alexcwu1121/hammerhead-sensor-module/kicad/hammerhead_sensor_module.step

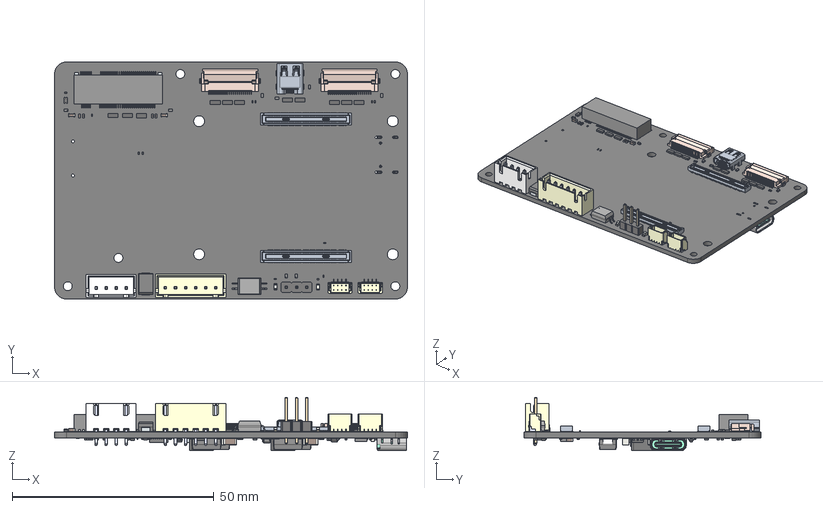
[picture p1: CAD file, 2026-08-22]
kicad/hammerhead_sensor_module.step
87.5 x 58.8 x 13.3 mm
10164227-1001a1rlf x 2
BaseWithTopCut x 25
TopCircle_NewBody x 25
DQA0010B_BODY x 15
DQA0010B_FRAME x 15
DQA0010B_PIN1-ID x 15
C_0402_1005Metric x 6
R_0201_0603Metric x 31
FH12-22S-0.5SH_Èª x 2
D_0603_1608Metric
LED_0603_1608Metric x 2
B6B-XH-A_LF__SN_
BxB-XH-A_04
FilletPin1
FilletPin2
C_0603_1608Metric x 3
Pins
Lugs
C_0201_0603Metric x 16
PinHeader_1x03_P2.54mm_Vertical
BM04B-SRSS-TB x 2
218-2-GULLWING_CTS
25TQC100MD3 x 2
C_1206_3216Metric x 6
R_0402_1005Metric x 2
BODY-SOT
LEAD-SOT x 5
LEAD-DUMMY
ETQP3M4R7KVN x 2
12402012E212A
PinsArrayLR x 3
SOT-416_1P65X0P9_ONS
ThermalPin
PinsArrayTB
TXB0108RGYR
10TPE220ML x 2
TSOT-23
term1
term2
hammerhead_sensor_module_PCB
