alexcwu1121/hammerhead-sensor-module/kicad/hammerhead_sensor_module.kicad_pcb

## KiCad design kicad/hammerhead_sensor_module.kicad_pcb (2026-08-26)

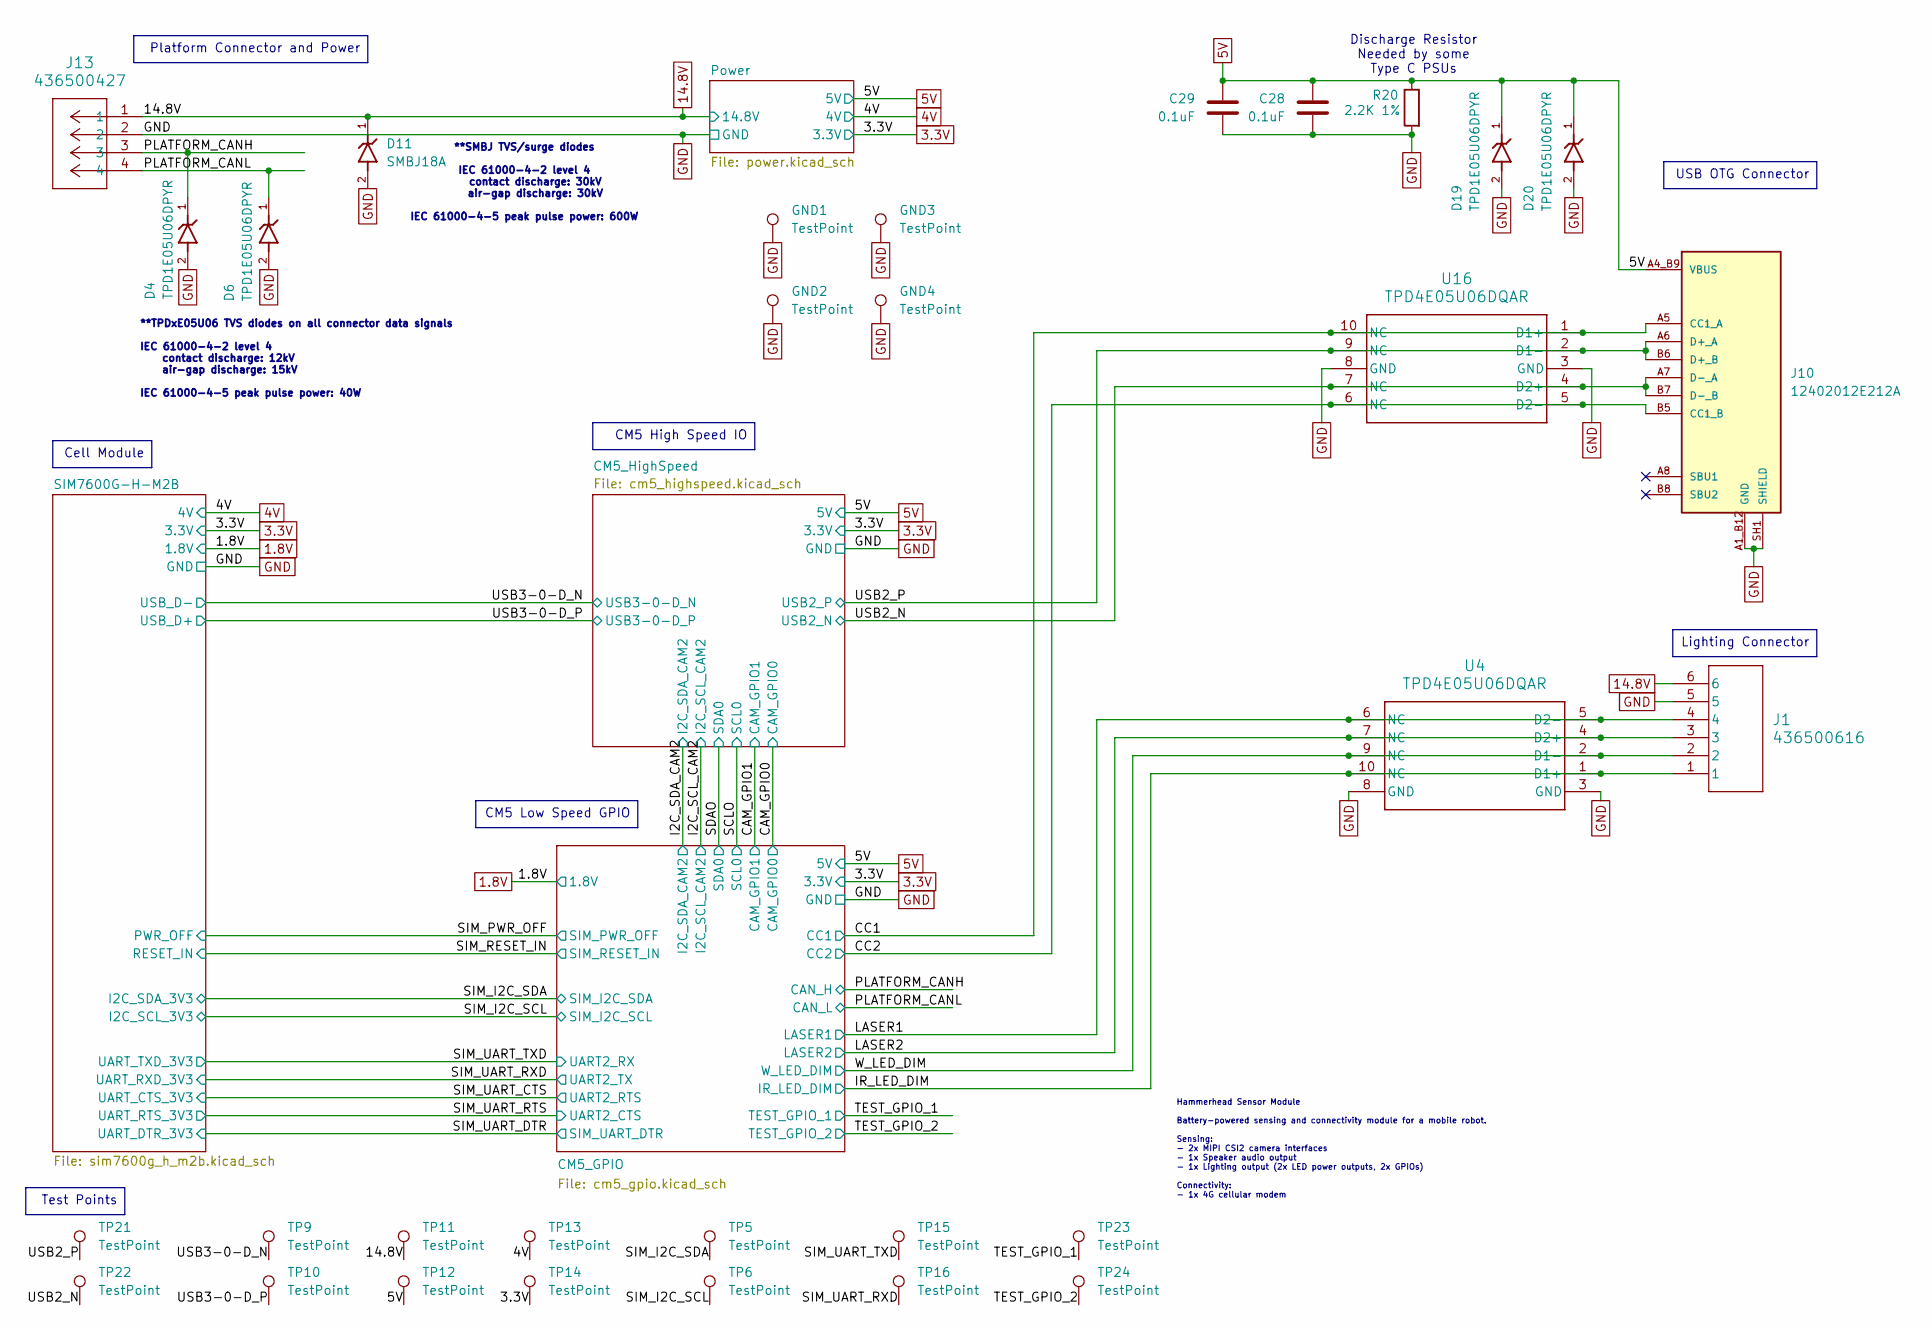
[picture p2: schematic hammerhead_sensor_module.kicad_sch]

Parts:
C28, C29: 0.1uF; C_0201_0603Metric
D4, D6, D19, D20: TPD1E05U06DPYR; SON65P60X100X45-2N
D11: SMBJ18A; DIOM5436X261N; PARTREV JC.07/04/25 v4
GND1, GND2, GND3, GND4: TestPoint; TestPoint_Pad_1.0x1.0mm
J1: 436500616; CONN_SD-43650-006_06_MOL
J10: 12402012E212A; AMPHENOL_12402012E212A; PARTREV 4
J13: 436500427; CONN_SD-43650-010_04_MOL
R20: 2.2K 1%; R_0201_0603Metric; Part Description Resistor 2.2K M1005 1% 63mW
TP5, TP6, TP9, TP10, TP11, TP12, TP13, TP14, TP15, TP16, TP21, TP22, TP23, TP24: TestPoint; TestPoint_Pad_1.0x1.0mm
U4, U16: TPD4E05U06DQAR; DQA0010A

Connections:
3.3V: TP14.1; also elsewhere on the board
4V: TP13.1; also elsewhere on the board
5V: C28.1, C29.1, D19.1, D20.1, J10.A4_B9 (VBUS), J10.B4_A9 (VBUS), R20.1, TP12.1; also elsewhere on the board
14.8V: D11.1, J1.6, J13.1, TP11.1; also elsewhere on the board
/CC1: J10.A5 (CC1_A), U16.1 (D1+), U16.10 (NC); also elsewhere on the board
/CC2: J10.B5 (CC1_B), U16.5 (D2-), U16.6 (NC); also elsewhere on the board
/IR_LED_DIM: J1.1, U4.1 (D1+), U4.10 (NC); also elsewhere on the board
/LASER1: J1.4, U4.5 (D2-), U4.6 (NC); also elsewhere on the board
/LASER2: J1.3, U4.4 (D2+), U4.7 (NC); also elsewhere on the board
/PLATFORM_CANH: D4.1, J13.3; also elsewhere on the board
/PLATFORM_CANL: D6.1, J13.4; also elsewhere on the board
/SIM_I2C_SCL: TP6.1; also elsewhere on the board
/SIM_I2C_SDA: TP5.1; also elsewhere on the board
/SIM_UART_RXD: TP16.1; also elsewhere on the board
/SIM_UART_TXD: TP15.1; also elsewhere on the board
/TEST_GPIO_1: TP23.1; also elsewhere on the board
/TEST_GPIO_2: TP24.1; also elsewhere on the board
/USB2_N: J10.A7 (D-_A), J10.B7 (D-_B), TP22.1, U16.4 (D2+), U16.7 (NC); also elsewhere on the board
/USB2_P: J10.A6 (D+_A), J10.B6 (D+_B), TP21.1, U16.2 (D1-), U16.9 (NC); also elsewhere on the board
/USB3-0-D_N: TP9.1; also elsewhere on the board
/USB3-0-D_P: TP10.1; also elsewhere on the board
/W_LED_DIM: J1.2, U4.2 (D1-), U4.9 (NC); also elsewhere on the board
GND: C28.2, C29.2, D4.2, D6.2, D11.2, D19.2, D20.2, GND1.1, GND2.1, GND3.1, GND4.1, J1.5, J10.A1_B12 (GND), J10.B1_A12 (GND), J10.SH1 (SHIELD), J10.SH2 (SHIELD), J10.SH3 (SHIELD), J10.SH4 (SHIELD), J13.2, R20.2, U4.3 (GND), U4.8 (GND), U16.3 (GND), U16.8 (GND); also elsewhere on the board

Notes on the sheet:
Hammerhead Sensor Module Battery-powered sensing and connectivity module for a mobile robot. Sensing: - 2x MIPI CSI2 camera interfaces - 1x Speaker audio output - 1x Lighting output (2x LED power outputs, 2x GPIOs) Connectivity: - 1x 4G cellular modem
**SMBJ TVS/surge diodes IEC 61000-4-2 level 4 contact discharge: 30kV air-gap discharge: 30kV IEC 61000-4-5 peak pulse power: 600W
**TPDxE05U06 TVS diodes on all connector data signals IEC 61000-4-2 level 4 contact discharge: 12kV air-gap discharge: 15kV IEC 61000-4-5 peak pulse power: 40W
Discharge Resistor Needed by some Type C PSUs
Cell Module
Test Points
USB OTG Connector
CM5 High Speed IO
Platform Connector and Power
Lighting Connector
CM5 Low Speed GPIO

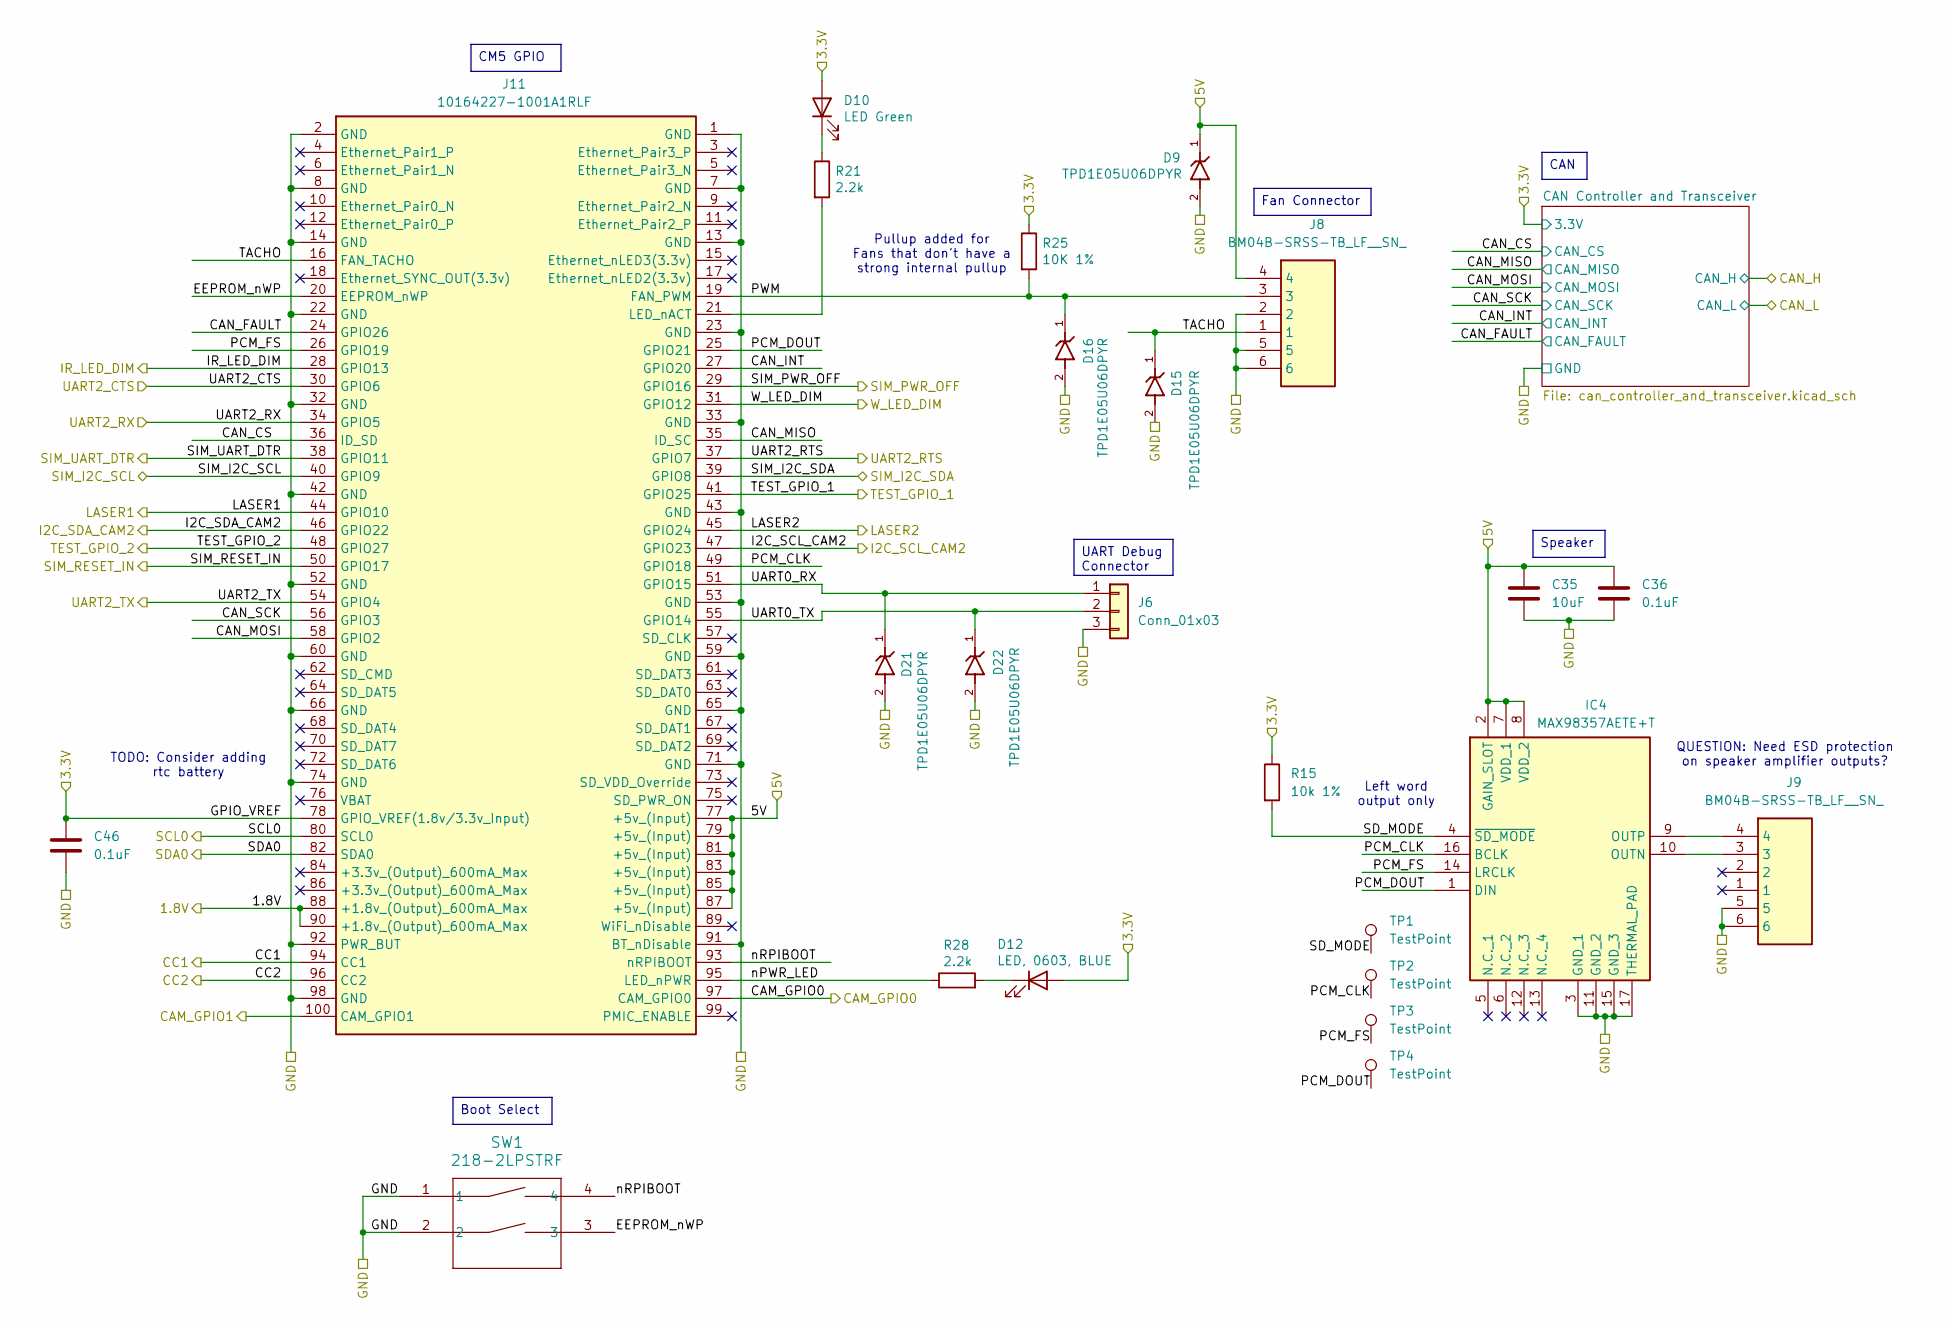
[picture p3: schematic cm5_gpio.kicad_sch]

Parts:
C35: 10uF; C_0603_1608Metric
C36, C46: 0.1uF; C_0201_0603Metric
D9, D15, D16, D21, D22: TPD1E05U06DPYR; SON65P60X100X45-2N
D10: LED Green; LED_0603_1608Metric; Part Description Green 572nm LED Indication - Discrete 2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
D12: LED, 0603, BLUE; LED_0603_1608Metric; Part Description Red 620nm LED Indication - Discrete 2.2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
IC4: MAX98357AETE+T; QFN50P300X300X80-17N; Manufacturer_Part_Number MAX98357AETE+T; Mouser Part Number 700-MAX98357AETE+T
J6: Conn_01x03; PinHeader_1x03_P2.54mm_Vertical
J8, J9: BM04B-SRSS-TB_LF__SN_; BM04B-SRSS-TB_LFSN_; Manufacturer_Part_Number BM04B-SRSS-TB(LF)(SN); Mouser Part Number N/A
J11: 10164227-1001A1RLF; 101642271001A1RLF; Manufacturer_Part_Number 10164227-1001A1RLF; Mouser Part Number 649-01642271001A1RLF
R15: 10k 1%; R_0201_0603Metric
R21, R28: 2.2k; R_0201_0603Metric; Part Description Resistor 1K M1005 1% 63mW
R25: 10K 1%; R_0201_0603Metric; Part Description Resistor 10K M1005 1% 63mW
SW1: 218-2LPSTRF; 218-2-GULLWING_CTS
TP1, TP2, TP3, TP4: TestPoint; TestPoint_Pad_1.0x1.0mm

Connections:
1.8V: J11.88 (+1.8v_(Output)_600mA_Max), J11.90 (+1.8v_(Output)_600mA_Max); also elsewhere on the board
3.3V: C46.1, D10.2 (A), D12.2 (A), J11.78 (GPIO_VREF(1.8v/3.3v_Input)), R15.1, R25.1; also elsewhere on the board
5V: C35.1, C36.1, D9.1, IC4.2 (GAIN_SLOT), IC4.7 (VDD_1), IC4.8 (VDD_2), J8.4, J11.77 (+5v_(Input)), J11.79 (+5v_(Input)), J11.81 (+5v_(Input)), J11.83 (+5v_(Input)), J11.85 (+5v_(Input)), J11.87 (+5v_(Input)); also elsewhere on the board
/CAM_GPIO0: J11.97 (CAM_GPIO0); also elsewhere on the board
/CAM_GPIO1: J11.100 (CAM_GPIO1); also elsewhere on the board
/CC1: J11.94 (CC1); also elsewhere on the board
/CC2: J11.96 (CC2); also elsewhere on the board
/CM5_GPIO/CAN_CS: J11.36 (ID_SD); also elsewhere on the board
/CM5_GPIO/CAN_FAULT: J11.24 (GPIO26); also elsewhere on the board
/CM5_GPIO/CAN_INT: J11.27 (GPIO20); also elsewhere on the board
/CM5_GPIO/CAN_MISO: J11.35 (ID_SC); also elsewhere on the board
/CM5_GPIO/CAN_MOSI: J11.58 (GPIO2); also elsewhere on the board
/CM5_GPIO/CAN_SCK: J11.56 (GPIO3); also elsewhere on the board
/CM5_GPIO/EEPROM_nWP: J11.20 (EEPROM_nWP), SW1.3
/CM5_GPIO/PCM_CLK: IC4.16 (BCLK), J11.49 (GPIO18), TP2.1
/CM5_GPIO/PCM_DOUT: IC4.1 (DIN), J11.25 (GPIO21), TP4.1
/CM5_GPIO/PCM_FS: IC4.14 (LRCLK), J11.26 (GPIO19), TP3.1
/CM5_GPIO/PWM: D16.1, J8.3, J11.19 (FAN_PWM), R25.2
/CM5_GPIO/SD_MODE: IC4.4 (~SD_MODE), R15.2, TP1.1
/CM5_GPIO/TACHO: D15.1, J8.1, J11.16 (FAN_TACHO)
/CM5_GPIO/UART0_RX: D21.1, J6.1, J11.51 (GPIO15)
/CM5_GPIO/UART0_TX: D22.1, J6.2, J11.55 (GPIO14)
/CM5_GPIO/nPWR_LED: J11.95 (LED_nPWR), R28.1
/CM5_GPIO/nRPIBOOT: J11.93 (nRPIBOOT), SW1.4
/I2C_SCL_CAM2: J11.47 (GPIO23); also elsewhere on the board
/I2C_SDA_CAM2: J11.46 (GPIO22); also elsewhere on the board
/IR_LED_DIM: J11.28 (GPIO13); also elsewhere on the board
/LASER1: J11.44 (GPIO10); also elsewhere on the board
/LASER2: J11.45 (GPIO24); also elsewhere on the board
/SCLO: J11.80 (SCL0); also elsewhere on the board
/SDAO: J11.82 (SDA0); also elsewhere on the board
/SIM_I2C_SCL: J11.40 (GPIO9); also elsewhere on the board
/SIM_I2C_SDA: J11.39 (GPIO8); also elsewhere on the board
/SIM_PWR_OFF: J11.29 (GPIO16); also elsewhere on the board
/SIM_RESET_IN: J11.50 (GPIO17); also elsewhere on the board
/SIM_UART_CTS: J11.37 (GPIO7); also elsewhere on the board
/SIM_UART_DTR: J11.38 (GPIO11); also elsewhere on the board
/SIM_UART_RTS: J11.30 (GPIO6); also elsewhere on the board
/SIM_UART_RXD: J11.54 (GPIO4); also elsewhere on the board
/SIM_UART_TXD: J11.34 (GPIO5); also elsewhere on the board
/TEST_GPIO_1: J11.41 (GPIO25); also elsewhere on the board
/TEST_GPIO_2: J11.48 (GPIO27); also elsewhere on the board
/W_LED_DIM: J11.31 (GPIO12); also elsewhere on the board
GND: C35.2, C36.2, C46.2, D9.2, D15.2, D16.2, D21.2, D22.2, IC4.3 (GND_1), IC4.11 (GND_2), IC4.15 (GND_3), IC4.17 (THERMAL_PAD), J6.3, J8.2, J8.5, J8.6, J9.5, J9.6, J11.1 (GND), J11.2 (GND), J11.7 (GND), J11.8 (GND), J11.13 (GND), J11.14 (GND), J11.22 (GND), J11.23 (GND), J11.32 (GND), J11.33 (GND), J11.42 (GND), J11.43 (GND), J11.52 (GND), J11.53 (GND), J11.59 (GND), J11.60 (GND), J11.65 (GND), J11.66 (GND), J11.71 (GND), J11.74 (GND), J11.91 (BT_nDisable), J11.92 (PWR_BUT), J11.98 (GND), SW1.1, SW1.2; also elsewhere on the board
unnamed: D10.1 (K), R21.1
unnamed: D12.1 (K), R28.2
unnamed: IC4.10 (OUTN), J9.3
unnamed: IC4.9 (OUTP), J9.4
unnamed: J11.21 (LED_nACT), R21.2

Notes on the sheet:
TODO: Consider adding rtc battery
Pullup added for Fans that don't have a strong internal pullup
QUESTION: Need ESD protection on speaker amplifier outputs?
Left word output only
UART Debug Connector
CM5 GPIO
Speaker
Boot Select
Fan Connector
CAN

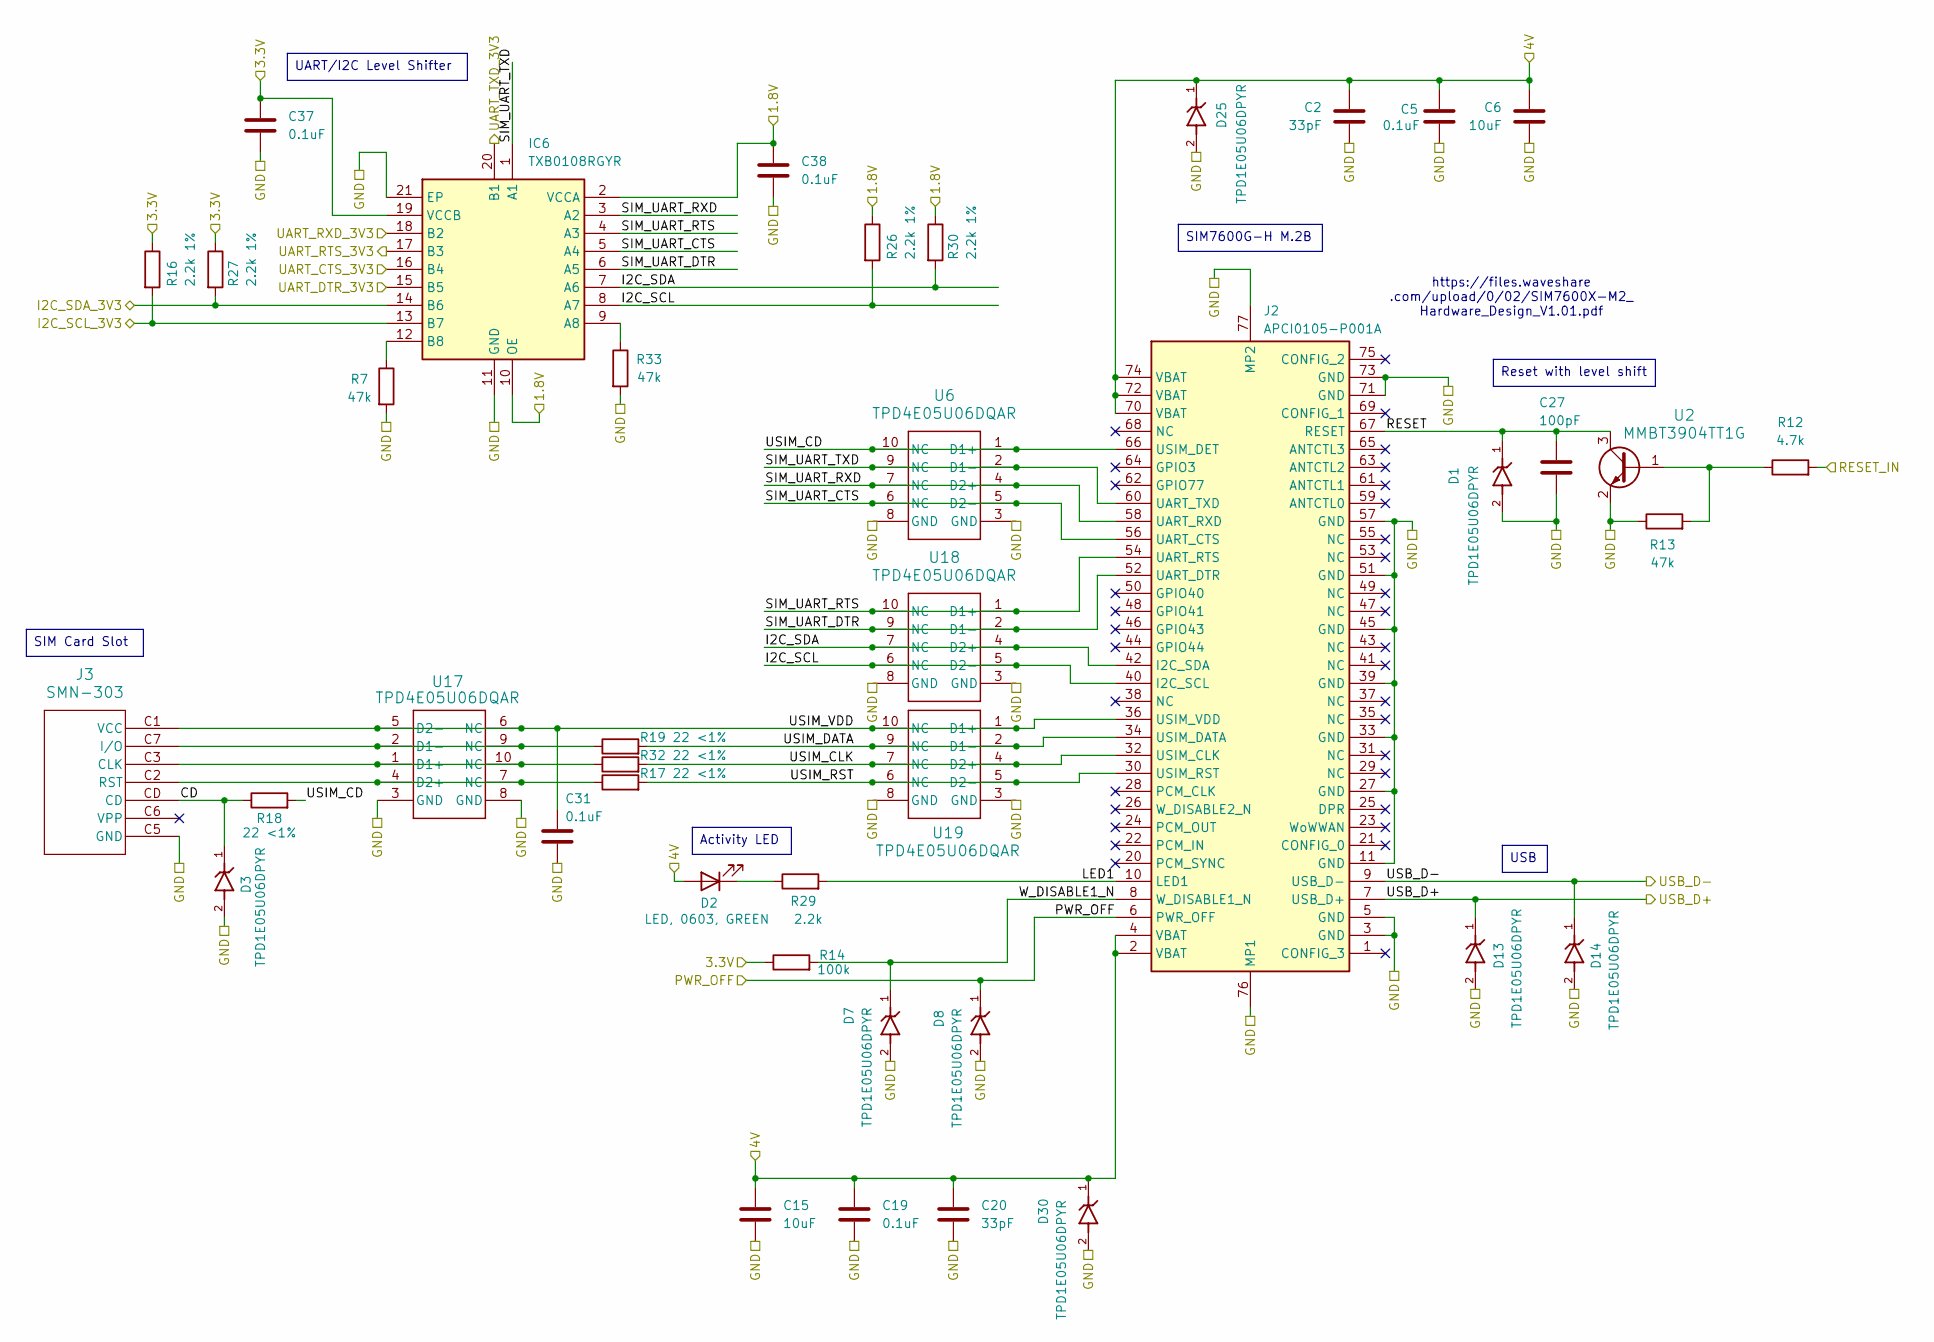
[picture p4: schematic sim7600g_h_m2b.kicad_sch]

Parts:
C2, C20: 33pF; C_0402_1005Metric
C5, C19: 0.1uF; C_0402_1005Metric
C6, C15: 10uF; C_0603_1608Metric
C27: 100pF; C_0201_0603Metric
C31, C37, C38: 0.1uF; C_0201_0603Metric
D1, D3, D7, D8, D13, D14, D25, D30: TPD1E05U06DPYR; SON65P60X100X45-2N
D2: LED, 0603, GREEN; D_0603_1608Metric
IC6: TXB0108RGYR; SN74LVC541ARGYR; Manufacturer_Part_Number TXB0108RGYR; Mouser Part Number 595-TXB0108RGYR
J2: APCI0105-P001A; APCI0105P001A; Manufacturer_Part_Number APCI0105-P001A
J3: SMN-303; SMN-303_XNP
R7, R13, R33: 47k; R_0201_0603Metric
R12: 4.7k; R_0201_0603Metric
R14: 100k; R_0201_0603Metric
R16, R26, R27, R30: 2.2k 1%; R_0201_0603Metric
R17, R18, R19, R32: 22 <1%; R_0201_0603Metric
R29: 2.2k; R_0201_0603Metric
U2: MMBT3904TT1G; SOT-416_1P65X0P9_ONS-L
U6, U17, U18, U19: TPD4E05U06DQAR; DQA0010A

Connections:
1.8V: C38.1, IC6.2 (VCCA), IC6.10 (OE), R26.1, R30.1; also elsewhere on the board
3.3V: C37.1, IC6.19 (VCCB), R14.1, R16.1, R27.1; also elsewhere on the board
4V: C2.1, C5.1, C6.1, C15.1, C19.1, C20.1, D2.2 (A), D25.1, D30.1, J2.2 (VBAT), J2.4 (VBAT), J2.70 (VBAT), J2.72 (VBAT), J2.74 (VBAT); also elsewhere on the board
/SIM7600G-H-M2B/CD: D3.1, J3.CD, R18.1
/SIM7600G-H-M2B/I2C_SCL: IC6.8 (A7), J2.40 (I2C_SCL), R26.2, U18.5 (D2-), U18.6 (NC)
/SIM7600G-H-M2B/I2C_SDA: IC6.7 (A6), J2.42 (I2C_SDA), R30.2, U18.4 (D2+), U18.7 (NC)
/SIM7600G-H-M2B/LED1: J2.10 (LED1), R29.2
/SIM7600G-H-M2B/RESET: C27.1, D1.1, J2.67 (RESET), U2.3
/SIM7600G-H-M2B/SIM_UART_CTS: IC6.5 (A4), J2.56 (UART_CTS), U6.5 (D2-), U6.6 (NC)
/SIM7600G-H-M2B/SIM_UART_DTR: IC6.6 (A5), J2.52 (UART_DTR), U18.2 (D1-), U18.9 (NC)
/SIM7600G-H-M2B/SIM_UART_RTS: IC6.4 (A3), J2.54 (UART_RTS), U18.1 (D1+), U18.10 (NC)
/SIM7600G-H-M2B/SIM_UART_RXD: IC6.3 (A2), J2.58 (UART_RXD), U6.4 (D2+), U6.7 (NC)
/SIM7600G-H-M2B/SIM_UART_TXD: IC6.1 (A1), J2.60 (UART_TXD), U6.2 (D1-), U6.9 (NC)
/SIM7600G-H-M2B/USIM_CD: J2.66 (USIM_DET), R18.2, U6.1 (D1+), U6.10 (NC)
/SIM7600G-H-M2B/USIM_CLK: J2.32 (USIM_CLK), R32.2, U19.4 (D2+), U19.7 (NC)
/SIM7600G-H-M2B/USIM_DATA: J2.34 (USIM_DATA), R19.2, U19.2 (D1-), U19.9 (NC)
/SIM7600G-H-M2B/USIM_RST: J2.30 (USIM_RST), R17.2, U19.5 (D2-), U19.6 (NC)
/SIM7600G-H-M2B/USIM_VDD: C31.1, J2.36 (USIM_VDD), J3.C1 (VCC), U17.5 (D2-), U17.6 (NC), U19.1 (D1+), U19.10 (NC)
/SIM7600G-H-M2B/W_DISABLE1_N: D7.1, J2.8 (W_DISABLE1_N), R14.2
/SIM_I2C_SCL: IC6.13 (B7), R16.2; also elsewhere on the board
/SIM_I2C_SDA: IC6.14 (B6), R27.2; also elsewhere on the board
/SIM_PWR_OFF: D8.1, J2.6 (PWR_OFF); also elsewhere on the board
/SIM_RESET_IN: R12.2; also elsewhere on the board
/SIM_UART_CTS: IC6.16 (B4); also elsewhere on the board
/SIM_UART_DTR: IC6.15 (B5); also elsewhere on the board
/SIM_UART_RTS: IC6.17 (B3); also elsewhere on the board
/SIM_UART_RXD: IC6.18 (B2); also elsewhere on the board
/SIM_UART_TXD: IC6.20 (B1); also elsewhere on the board
/USB3-0-D_N: D14.1, J2.9 (USB_D-); also elsewhere on the board
/USB3-0-D_P: D13.1, J2.7 (USB_D+); also elsewhere on the board
GND: C2.2, C5.2, C6.2, C15.2, C19.2, C20.2, C27.2, C31.2, C37.2, C38.2, D1.2, D3.2, D7.2, D8.2, D13.2, D14.2, D25.2, D30.2, IC6.11 (GND), IC6.21 (EP), J2.3 (GND), J2.5 (GND), J2.11 (GND), J2.27 (GND), J2.33 (GND), J2.39 (GND), J2.45 (GND), J2.51 (GND), J2.57 (GND), J2.71 (GND), J2.73 (GND), J2.76 (MP1), J2.77 (MP2), J3.C5 (GND), R7.2, R13.1, R33.2, U2.2, U6.3 (GND), U6.8 (GND), U17.3 (GND), U17.8 (GND), U18.3 (GND), U18.8 (GND), U19.3 (GND), U19.8 (GND); also elsewhere on the board
unnamed: D2.1 (K), R29.1
unnamed: IC6.9 (A8), R33.1
unnamed: IC6.12 (B8), R7.1
unnamed: J3.C3 (CLK), R32.1, U17.1 (D1+), U17.10 (NC)
unnamed: J3.C7 (I/O), R19.1, U17.2 (D1-), U17.9 (NC)
unnamed: J3.C2 (RST), R17.1, U17.4 (D2+), U17.7 (NC)
unnamed: R12.1, R13.2, U2.1

Notes on the sheet:
https://files.waveshare .com/upload/0/02/SIM7600X-M2_ Hardware_Design_V1.01.pdf
USB
Reset with level shift
SIM Card Slot
SIM7600G-H M.2B
Activity LED
UART/I2C Level Shifter

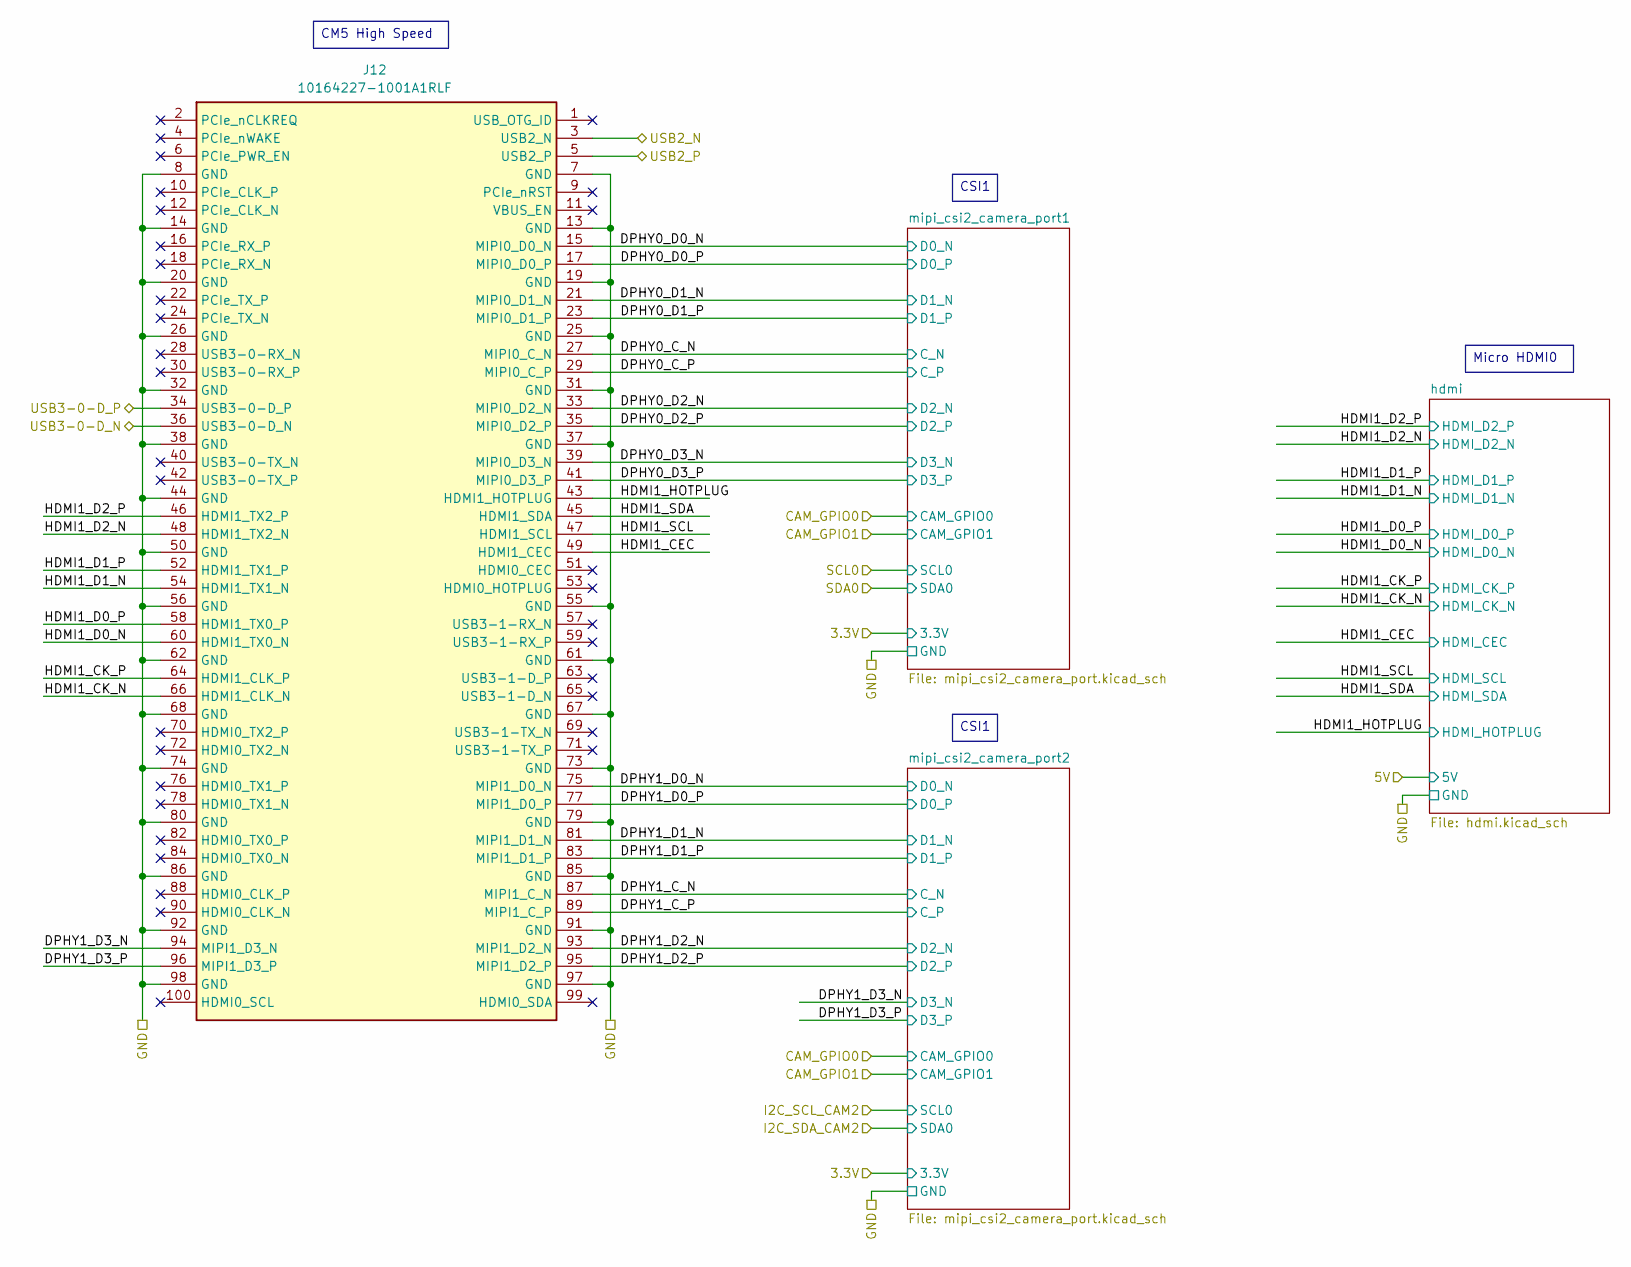
[picture p5: schematic cm5_highspeed.kicad_sch]

Parts:
J12: 10164227-1001A1RLF; 101642271001A1RLF; Manufacturer_Part_Number 10164227-1001A1RLF; Mouser Part Number 649-01642271001A1RLF

Connections:
/CM5_HighSpeed/DPHY0_C_N: J12.27 (MIPI0_C_N); also elsewhere on the board
/CM5_HighSpeed/DPHY0_C_P: J12.29 (MIPI0_C_P); also elsewhere on the board
/CM5_HighSpeed/DPHY0_D0_N: J12.15 (MIPI0_D0_N); also elsewhere on the board
/CM5_HighSpeed/DPHY0_D0_P: J12.17 (MIPI0_D0_P); also elsewhere on the board
/CM5_HighSpeed/DPHY0_D1_N: J12.21 (MIPI0_D1_N); also elsewhere on the board
/CM5_HighSpeed/DPHY0_D1_P: J12.23 (MIPI0_D1_P); also elsewhere on the board
/CM5_HighSpeed/DPHY0_D2_N: J12.33 (MIPI0_D2_N); also elsewhere on the board
/CM5_HighSpeed/DPHY0_D2_P: J12.35 (MIPI0_D2_P); also elsewhere on the board
/CM5_HighSpeed/DPHY0_D3_N: J12.39 (MIPI0_D3_N); also elsewhere on the board
/CM5_HighSpeed/DPHY0_D3_P: J12.41 (MIPI0_D3_P); also elsewhere on the board
/CM5_HighSpeed/DPHY1_C_N: J12.87 (MIPI1_C_N); also elsewhere on the board
/CM5_HighSpeed/DPHY1_C_P: J12.89 (MIPI1_C_P); also elsewhere on the board
/CM5_HighSpeed/DPHY1_D0_N: J12.75 (MIPI1_D0_N); also elsewhere on the board
/CM5_HighSpeed/DPHY1_D0_P: J12.77 (MIPI1_D0_P); also elsewhere on the board
/CM5_HighSpeed/DPHY1_D1_N: J12.81 (MIPI1_D1_N); also elsewhere on the board
/CM5_HighSpeed/DPHY1_D1_P: J12.83 (MIPI1_D1_P); also elsewhere on the board
/CM5_HighSpeed/DPHY1_D2_N: J12.93 (MIPI1_D2_N); also elsewhere on the board
/CM5_HighSpeed/DPHY1_D2_P: J12.95 (MIPI1_D2_P); also elsewhere on the board
/CM5_HighSpeed/DPHY1_D3_N: J12.94 (MIPI1_D3_N); also elsewhere on the board
/CM5_HighSpeed/DPHY1_D3_P: J12.96 (MIPI1_D3_P); also elsewhere on the board
/CM5_HighSpeed/HDMI1_CEC: J12.49 (HDMI1_CEC); also elsewhere on the board
/CM5_HighSpeed/HDMI1_CK_N: J12.66 (HDMI1_CLK_N); also elsewhere on the board
/CM5_HighSpeed/HDMI1_CK_P: J12.64 (HDMI1_CLK_P); also elsewhere on the board
/CM5_HighSpeed/HDMI1_D0_N: J12.60 (HDMI1_TX0_N); also elsewhere on the board
/CM5_HighSpeed/HDMI1_D0_P: J12.58 (HDMI1_TX0_P); also elsewhere on the board
/CM5_HighSpeed/HDMI1_D1_N: J12.54 (HDMI1_TX1_N); also elsewhere on the board
/CM5_HighSpeed/HDMI1_D1_P: J12.52 (HDMI1_TX1_P); also elsewhere on the board
/CM5_HighSpeed/HDMI1_D2_N: J12.48 (HDMI1_TX2_N); also elsewhere on the board
/CM5_HighSpeed/HDMI1_D2_P: J12.46 (HDMI1_TX2_P); also elsewhere on the board
/CM5_HighSpeed/HDMI1_HOTPLUG: J12.43 (HDMI1_HOTPLUG); also elsewhere on the board
/CM5_HighSpeed/HDMI1_SCL: J12.47 (HDMI1_SCL); also elsewhere on the board
/CM5_HighSpeed/HDMI1_SDA: J12.45 (HDMI1_SDA); also elsewhere on the board
/USB2_N: J12.3 (USB2_N); also elsewhere on the board
/USB2_P: J12.5 (USB2_P); also elsewhere on the board
/USB3-0-D_N: J12.36 (USB3-0-D_N); also elsewhere on the board
/USB3-0-D_P: J12.34 (USB3-0-D_P); also elsewhere on the board
GND: J12.7 (GND), J12.8 (GND), J12.13 (GND), J12.14 (GND), J12.19 (GND), J12.20 (GND), J12.25 (GND), J12.26 (GND), J12.31 (GND), J12.32 (GND), J12.37 (GND), J12.38 (GND), J12.44 (GND), J12.50 (GND), J12.55 (GND), J12.56 (GND), J12.61 (GND), J12.62 (GND), J12.67 (GND), J12.68 (GND), J12.73 (GND), J12.74 (GND), J12.79 (GND), J12.80 (GND), J12.85 (GND), J12.86 (GND), J12.91 (GND), J12.92 (GND), J12.97 (GND), J12.98 (GND); also elsewhere on the board

Notes on the sheet:
CSI1
Micro HDMI0
CM5 High Speed

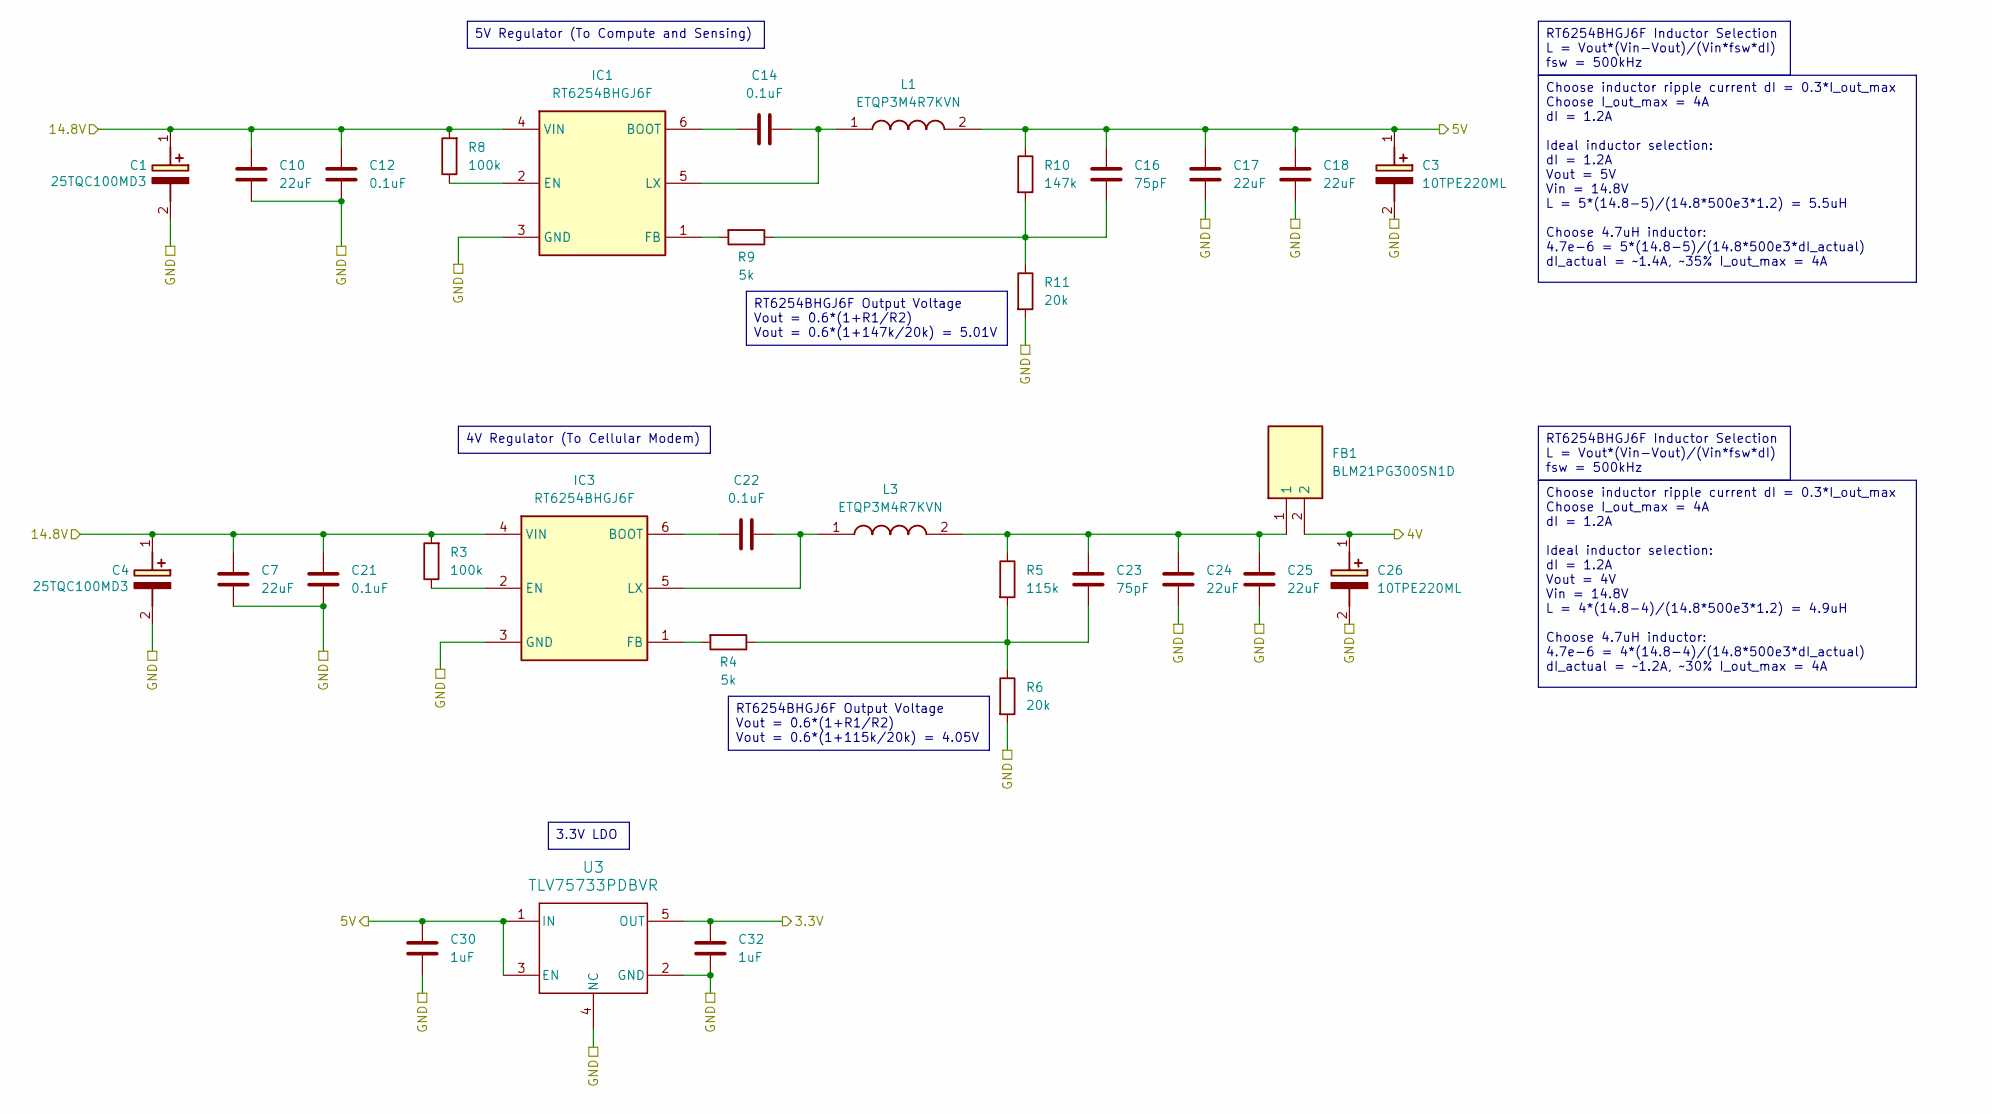
[picture p6: schematic power.kicad_sch]

Parts:
C1, C4: 25TQC100MD3; 16TDC150MYF; Manufacturer_Part_Number 25TQC100MD3; Mouser Part Number 667-25TQC100MD3
C3, C26: 10TPE220ML; 16TDC150MYF; Manufacturer_Part_Number 10TPE220ML; Mouser Part Number 667-10TPE220ML
C7, C10, C17, C18, C24, C25: 22uF; C_1206_3216Metric
C12, C14, C21, C22: 0.1uF; C_0201_0603Metric
C16, C23: 75pF; C_0201_0603Metric
C30, C32: 1uF; C_0201_0603Metric
FB1: BLM21PG300SN1D; BEADC2012X105N; Manufacturer_Part_Number BLM21PG300SN1D; Mouser Part Number 81-BLM21P300S
IC1, IC3: RT6254BHGJ6F; SOT95P280X100-6N; Manufacturer_Part_Number RT6254BHGJ6F; Mouser Part Number 835-RT6254BHGJ6F
L1, L3: ETQP3M4R7KVN; ETQP3M1R0KVN; Manufacturer_Part_Number ETQP3M4R7KVN
R3, R8: 100k; R_0201_0603Metric
R4, R9: 5k; R_0201_0603Metric
R5: 115k; R_0402_1005Metric
R6, R11: 20k; R_0201_0603Metric
R10: 147k; R_0402_1005Metric
U3: TLV75733PDBVR; DBV0005A_N

Connections:
3.3V: C32.1, U3.5 (OUT); also elsewhere on the board
4V: C26.1 (+), FB1.2; also elsewhere on the board
5V: C3.1 (+), C16.1, C17.1, C18.1, C30.1, L1.2, R10.1, U3.1 (IN), U3.3 (EN); also elsewhere on the board
14.8V: C1.1 (+), C4.1 (+), C7.1, C10.1, C12.1, C21.1, IC1.4 (VIN), IC3.4 (VIN), R3.2, R8.2; also elsewhere on the board
GND: C1.2 (-), C3.2 (-), C4.2 (-), C7.2, C10.2, C12.2, C17.2, C18.2, C21.2, C24.2, C25.2, C26.2 (-), C30.2, C32.2, IC1.3 (GND), IC3.3 (GND), R6.2, R11.2, U3.2 (GND), U3.4 (NC); also elsewhere on the board
unnamed: C16.2, R9.1, R10.2, R11.1
unnamed: C23.1, C24.1, C25.1, FB1.1, L3.2, R5.1
unnamed: C23.2, R4.1, R5.2, R6.1
unnamed: C14.1, IC1.6 (BOOT)
unnamed: IC1.2 (EN), R8.1
unnamed: IC1.1 (FB), R9.2
unnamed: C14.2, IC1.5 (LX), L1.1
unnamed: C22.1, IC3.6 (BOOT)
unnamed: IC3.2 (EN), R3.1
unnamed: IC3.1 (FB), R4.2
unnamed: C22.2, IC3.5 (LX), L3.1

Notes on the sheet:
Choose inductor ripple current dI = 0.3*I_out_max Choose I_out_max = 4A dI = 1.2A Ideal inductor selection: dI = 1.2A Vout = 5V Vin = 14.8V L = 5*(14.8-5)/(14.8*500e3*1.2) = 5.5uH Choose 4.7uH inductor: 4.7e-6 = 5*(14.8-5)/(14.8*500e3*dI_actual) dI_actual = ~1.4A, ~35% I_out_max = 4A
RT6254BHGJ6F Inductor Selection L = Vout*(Vin-Vout)/(Vin*fsw*dI) fsw = 500kHz
5V Regulator (To Compute and Sensing)
4V Regulator (To Cellular Modem)
RT6254BHGJ6F Output Voltage Vout = 0.6*(1+R1/R2) Vout = 0.6*(1+147k/20k) = 5.01V
3.3V LDO
RT6254BHGJ6F Output Voltage Vout = 0.6*(1+R1/R2) Vout = 0.6*(1+115k/20k) = 4.05V
Choose inductor ripple current dI = 0.3*I_out_max Choose I_out_max = 4A dI = 1.2A Ideal inductor selection: dI = 1.2A Vout = 4V Vin = 14.8V L = 4*(14.8-4)/(14.8*500e3*1.2) = 4.9uH Choose 4.7uH inductor: 4.7e-6 = 4*(14.8-4)/(14.8*500e3*dI_actual) dI_actual = ~1.2A, ~30% I_out_max = 4A
