alexcwu1121/hammerhead-sensor-module/kicad/hammerhead_sensor_module.kicad_pcb

## KiCad design kicad/hammerhead_sensor_module.kicad_pcb (continued)

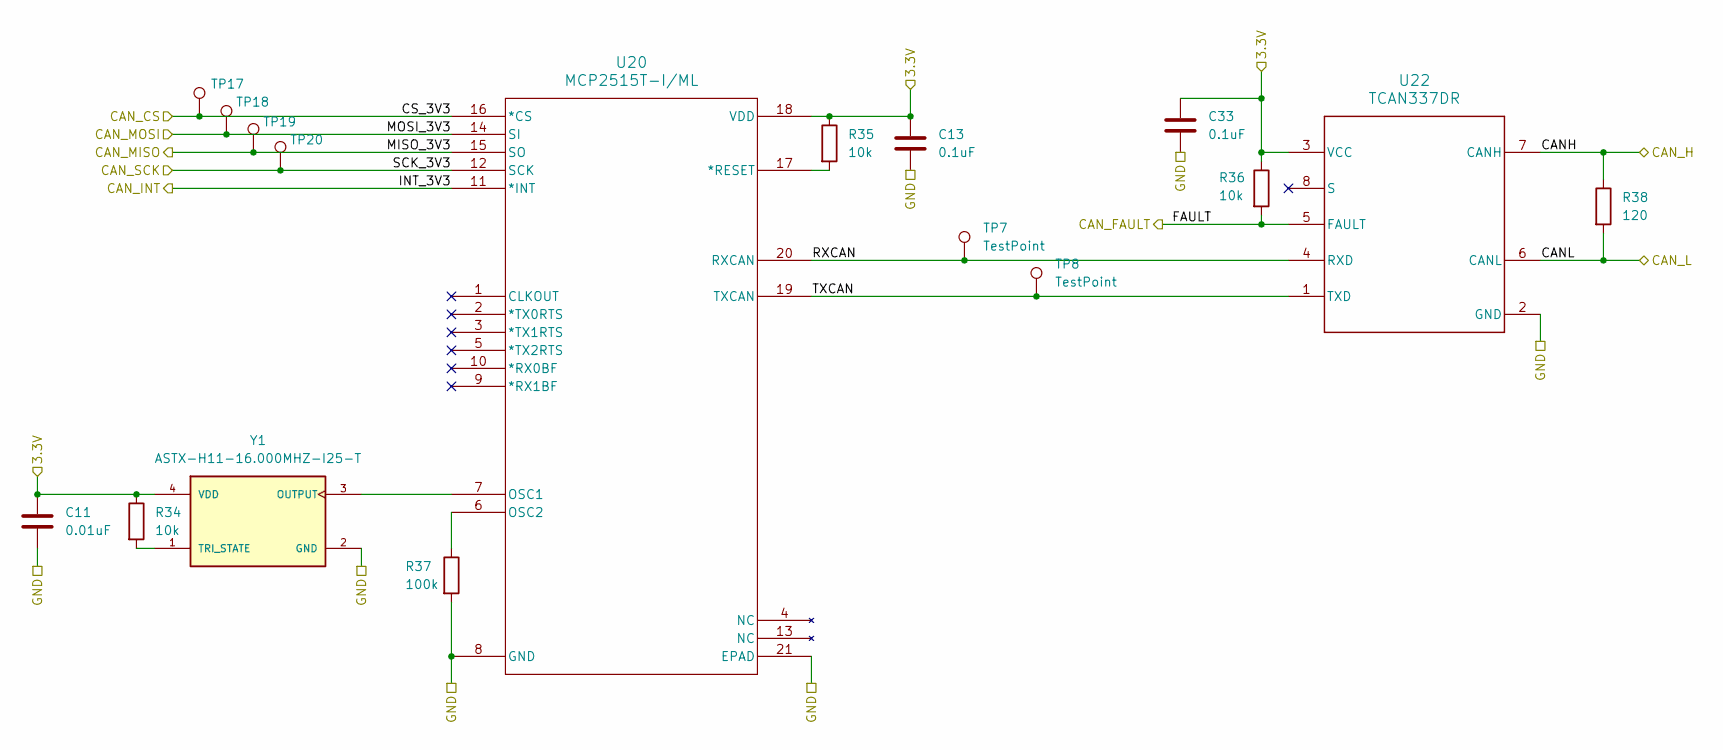
[picture p7: schematic can_controller_and_transceiver.kicad_sch]

Parts:
C11: 0.01uF; C_0402_1005Metric
C13, C33: 0.1uF; C_0402_1005Metric
R34, R35, R36: 10k; R_0402_1005Metric
R37: 100k; R_0402_1005Metric
R38: 120; R_0603_1608Metric
TP7, TP8, TP17, TP18, TP19, TP20: TestPoint; TestPoint_Pad_1.0x1.0mm
U20: MCP2515T-I/ML; QFN20_4x4MC_MCH
U22: TCAN337DR; D0008A_N
Y1: ASTX-H11-16.000MHZ-I25-T; XTAL_ASTX-H11-16.000MHZ-I25-T; PARTREV 05.13.15

Connections:
3.3V: C11.1, C13.1, C33.1, R34.1, R35.1, R36.1, U20.18 (VDD), U22.3 (VCC), Y1.4 (VDD); also elsewhere on the board
/CM5_GPIO/CAN Controller and Transceiver/RXCAN: TP7.1, U20.20 (RXCAN), U22.4 (RXD)
/CM5_GPIO/CAN Controller and Transceiver/TXCAN: TP8.1, U20.19 (TXCAN), U22.1 (TXD)
/CM5_GPIO/CAN_CS: TP17.1, U20.16 (*CS); also elsewhere on the board
/CM5_GPIO/CAN_FAULT: R36.2, U22.5 (FAULT); also elsewhere on the board
/CM5_GPIO/CAN_INT: U20.11 (*INT); also elsewhere on the board
/CM5_GPIO/CAN_MISO: TP19.1, U20.15 (SO); also elsewhere on the board
/CM5_GPIO/CAN_MOSI: TP18.1, U20.14 (SI); also elsewhere on the board
/CM5_GPIO/CAN_SCK: TP20.1, U20.12 (SCK); also elsewhere on the board
/PLATFORM_CANH: R38.1, U22.7 (CANH); also elsewhere on the board
/PLATFORM_CANL: R38.2, U22.6 (CANL); also elsewhere on the board
GND: C11.2, C13.2, C33.2, R37.2, U20.8 (GND), U20.21 (EPAD), U22.2 (GND), Y1.2 (GND); also elsewhere on the board
unnamed: R35.2, U20.17 (*RESET)
unnamed: U20.7 (OSC1), Y1.3 (OUTPUT)
unnamed: R37.1, U20.6 (OSC2)
unnamed: R34.2, Y1.1 (TRI_STATE)

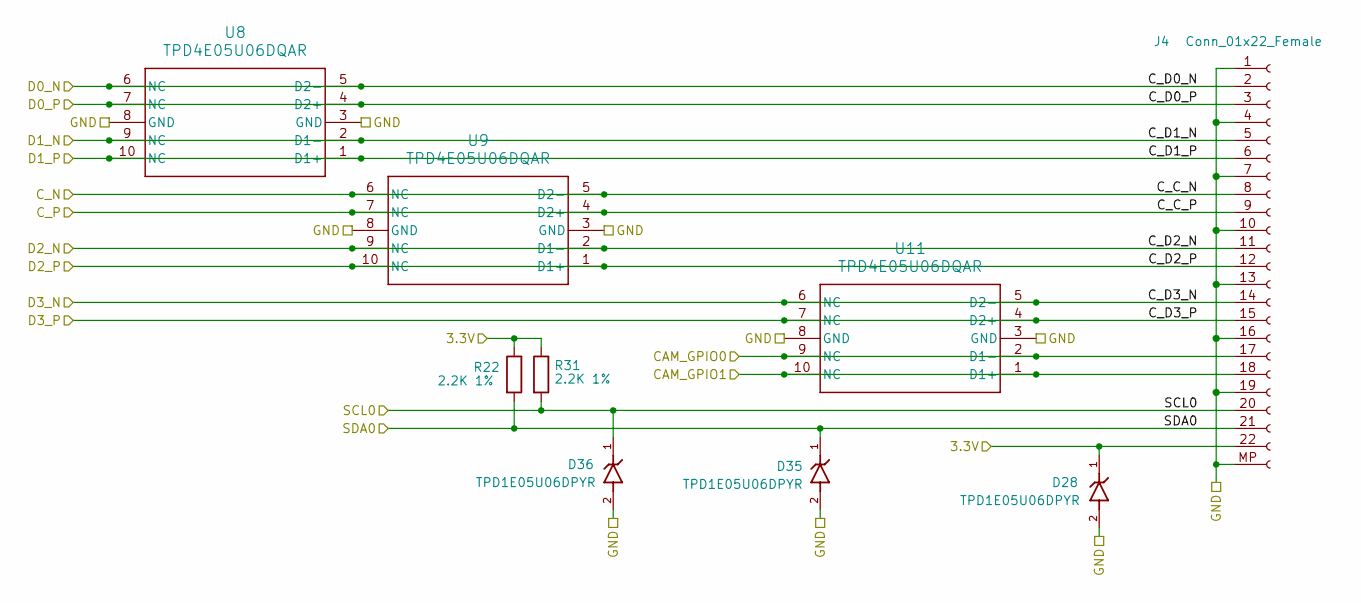
[picture p8: schematic mipi_csi2_camera_port.kicad_sch]

Parts:
D28, D35, D36: TPD1E05U06DPYR; SON65P60X100X45-2N
J4: Conn_01x22_Female; Hirose_FH12-22S-0.5SH_1x22-1MP_P0.50mm_Horizontal; Part Description 22 Position FFC, FPC Connector Contacts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
R22, R31: 2.2K 1%; R_0201_0603Metric; Part Description Resistor 2.2K M1005 1% 63mW
U8, U9, U11: TPD4E05U06DQAR; DQA0010A

Connections:
3.3V: D28.1, J4.22, R22.1, R31.1; also elsewhere on the board
/CAM_GPIO0: J4.17, U11.2 (D1-), U11.9 (NC); also elsewhere on the board
/CAM_GPIO1: J4.18, U11.1 (D1+), U11.10 (NC); also elsewhere on the board
/CM5_HighSpeed/DPHY0_C_N: J4.8, U9.5 (D2-), U9.6 (NC); also elsewhere on the board
/CM5_HighSpeed/DPHY0_C_P: J4.9, U9.4 (D2+), U9.7 (NC); also elsewhere on the board
/CM5_HighSpeed/DPHY0_D0_N: J4.2, U8.5 (D2-), U8.6 (NC); also elsewhere on the board
/CM5_HighSpeed/DPHY0_D0_P: J4.3, U8.4 (D2+), U8.7 (NC); also elsewhere on the board
/CM5_HighSpeed/DPHY0_D1_N: J4.5, U8.2 (D1-), U8.9 (NC); also elsewhere on the board
/CM5_HighSpeed/DPHY0_D1_P: J4.6, U8.1 (D1+), U8.10 (NC); also elsewhere on the board
/CM5_HighSpeed/DPHY0_D2_N: J4.11, U9.2 (D1-), U9.9 (NC); also elsewhere on the board
/CM5_HighSpeed/DPHY0_D2_P: J4.12, U9.1 (D1+), U9.10 (NC); also elsewhere on the board
/CM5_HighSpeed/DPHY0_D3_N: J4.14, U11.5 (D2-), U11.6 (NC); also elsewhere on the board
/CM5_HighSpeed/DPHY0_D3_P: J4.15, U11.4 (D2+), U11.7 (NC); also elsewhere on the board
/SCLO: D36.1, J4.20, R31.2; also elsewhere on the board
/SDAO: D35.1, J4.21, R22.2; also elsewhere on the board
GND: D28.2, D35.2, D36.2, J4.1, J4.4, J4.7, J4.10, J4.13, J4.16, J4.19, J4.MP, U8.3 (GND), U8.8 (GND), U9.3 (GND), U9.8 (GND), U11.3 (GND), U11.8 (GND); also elsewhere on the board

Parts of its further copies:
D17, D18, D29: TPD1E05U06DPYR; SON65P60X100X45-2N
J5: Conn_01x22_Female; Hirose_FH12-22S-0.5SH_1x22-1MP_P0.50mm_Horizontal; Part Description 22 Position FFC, FPC Connector Contacts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
R23, R24: 2.2K 1%; R_0201_0603Metric; Part Description Resistor 2.2K M1005 1% 63mW
U7, U10, U14: TPD4E05U06DQAR; DQA0010A

Connections of its further copies:
3.3V: D29.1, J5.22, R23.1, R24.1; also elsewhere on the board
/CAM_GPIO0: J5.17, U14.2 (D1-), U14.9 (NC); also elsewhere on the board
/CAM_GPIO1: J5.18, U14.1 (D1+), U14.10 (NC); also elsewhere on the board
/CM5_HighSpeed/DPHY1_C_N: J5.8, U10.5 (D2-), U10.6 (NC); also elsewhere on the board
/CM5_HighSpeed/DPHY1_C_P: J5.9, U10.4 (D2+), U10.7 (NC); also elsewhere on the board
/CM5_HighSpeed/DPHY1_D0_N: J5.2, U7.5 (D2-), U7.6 (NC); also elsewhere on the board
/CM5_HighSpeed/DPHY1_D0_P: J5.3, U7.4 (D2+), U7.7 (NC); also elsewhere on the board
/CM5_HighSpeed/DPHY1_D1_N: J5.5, U7.2 (D1-), U7.9 (NC); also elsewhere on the board
/CM5_HighSpeed/DPHY1_D1_P: J5.6, U7.1 (D1+), U7.10 (NC); also elsewhere on the board
/CM5_HighSpeed/DPHY1_D2_N: J5.11, U10.2 (D1-), U10.9 (NC); also elsewhere on the board
/CM5_HighSpeed/DPHY1_D2_P: J5.12, U10.1 (D1+), U10.10 (NC); also elsewhere on the board
/CM5_HighSpeed/DPHY1_D3_N: J5.14, U14.5 (D2-), U14.6 (NC); also elsewhere on the board
/CM5_HighSpeed/DPHY1_D3_P: J5.15, U14.4 (D2+), U14.7 (NC); also elsewhere on the board
/I2C_SCL_CAM2: D17.1, J5.20, R24.2; also elsewhere on the board
/I2C_SDA_CAM2: D18.1, J5.21, R23.2; also elsewhere on the board
GND: D17.2, D18.2, D29.2, J5.1, J5.4, J5.7, J5.10, J5.13, J5.16, J5.19, J5.MP, U7.3 (GND), U7.8 (GND), U10.3 (GND), U10.8 (GND), U14.3 (GND), U14.8 (GND); also elsewhere on the board

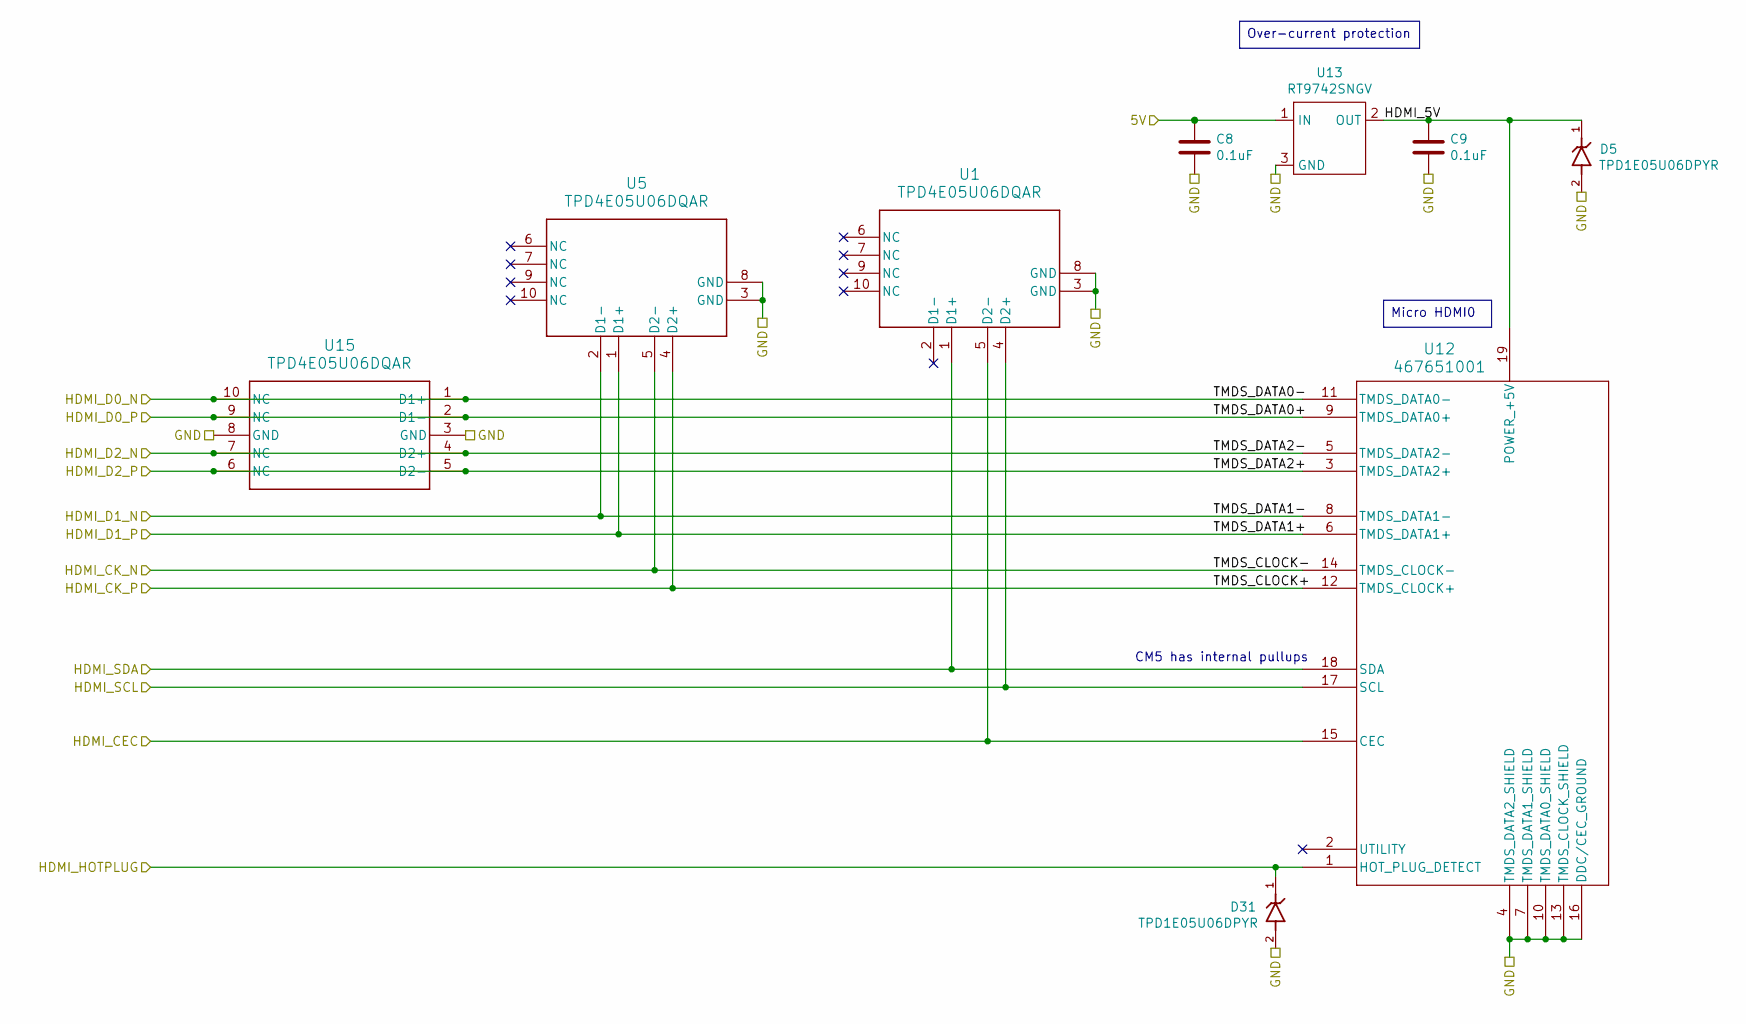
[picture p9: schematic hdmi.kicad_sch]

Parts:
C8, C9: 0.1uF; C_0402_1005Metric; Part Description 0.1uF 10% 16V Ceramic Capacitor X7R 040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
D5, D31: TPD1E05U06DPYR; SON65P60X100X45-2N
U1, U5, U15: TPD4E05U06DQAR; DQA0010A
U12: 467651001; 46765-1001_MOL
U13: RT9742SNGV; TSOT-23; Part Description Power Switch/Driver 1:1 N-Channel 500mA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

Connections:
5V: C8.1, U13.1 (IN); also elsewhere on the board
/CM5_HighSpeed/HDMI1_CEC: U1.5 (D2-), U12.15 (CEC); also elsewhere on the board
/CM5_HighSpeed/HDMI1_CK_N: U5.5 (D2-), U12.14 (TMDS_CLOCK-); also elsewhere on the board
/CM5_HighSpeed/HDMI1_CK_P: U5.4 (D2+), U12.12 (TMDS_CLOCK+); also elsewhere on the board
/CM5_HighSpeed/HDMI1_D0_N: U12.11 (TMDS_DATA0-), U15.1 (D1+), U15.10 (NC); also elsewhere on the board
/CM5_HighSpeed/HDMI1_D0_P: U12.9 (TMDS_DATA0+), U15.2 (D1-), U15.9 (NC); also elsewhere on the board
/CM5_HighSpeed/HDMI1_D1_N: U5.2 (D1-), U12.8 (TMDS_DATA1-); also elsewhere on the board
/CM5_HighSpeed/HDMI1_D1_P: U5.1 (D1+), U12.6 (TMDS_DATA1+); also elsewhere on the board
/CM5_HighSpeed/HDMI1_D2_N: U12.5 (TMDS_DATA2-), U15.4 (D2+), U15.7 (NC); also elsewhere on the board
/CM5_HighSpeed/HDMI1_D2_P: U12.3 (TMDS_DATA2+), U15.5 (D2-), U15.6 (NC); also elsewhere on the board
/CM5_HighSpeed/HDMI1_HOTPLUG: D31.1, U12.1 (HOT_PLUG_DETECT); also elsewhere on the board
/CM5_HighSpeed/HDMI1_SCL: U1.4 (D2+), U12.17 (SCL); also elsewhere on the board
/CM5_HighSpeed/HDMI1_SDA: U1.1 (D1+), U12.18 (SDA); also elsewhere on the board
/CM5_HighSpeed/hdmi/HDMI_5V: C9.1, D5.1, U12.19 (POWER_+5V), U13.2 (OUT)
GND: C8.2, C9.2, D5.2, D31.2, U1.3 (GND), U1.8 (GND), U5.3 (GND), U5.8 (GND), U12.4 (TMDS_DATA2_SHIELD), U12.7 (TMDS_DATA1_SHIELD), U12.10 (TMDS_DATA0_SHIELD), U12.13 (TMDS_CLOCK_SHIELD), U12.16 (DDC/CEC_GROUND), U13.3 (GND), U15.3 (GND), U15.8 (GND); also elsewhere on the board

Notes on the sheet:
CM5 has internal pullups
Micro HDMI0
Over-current protection

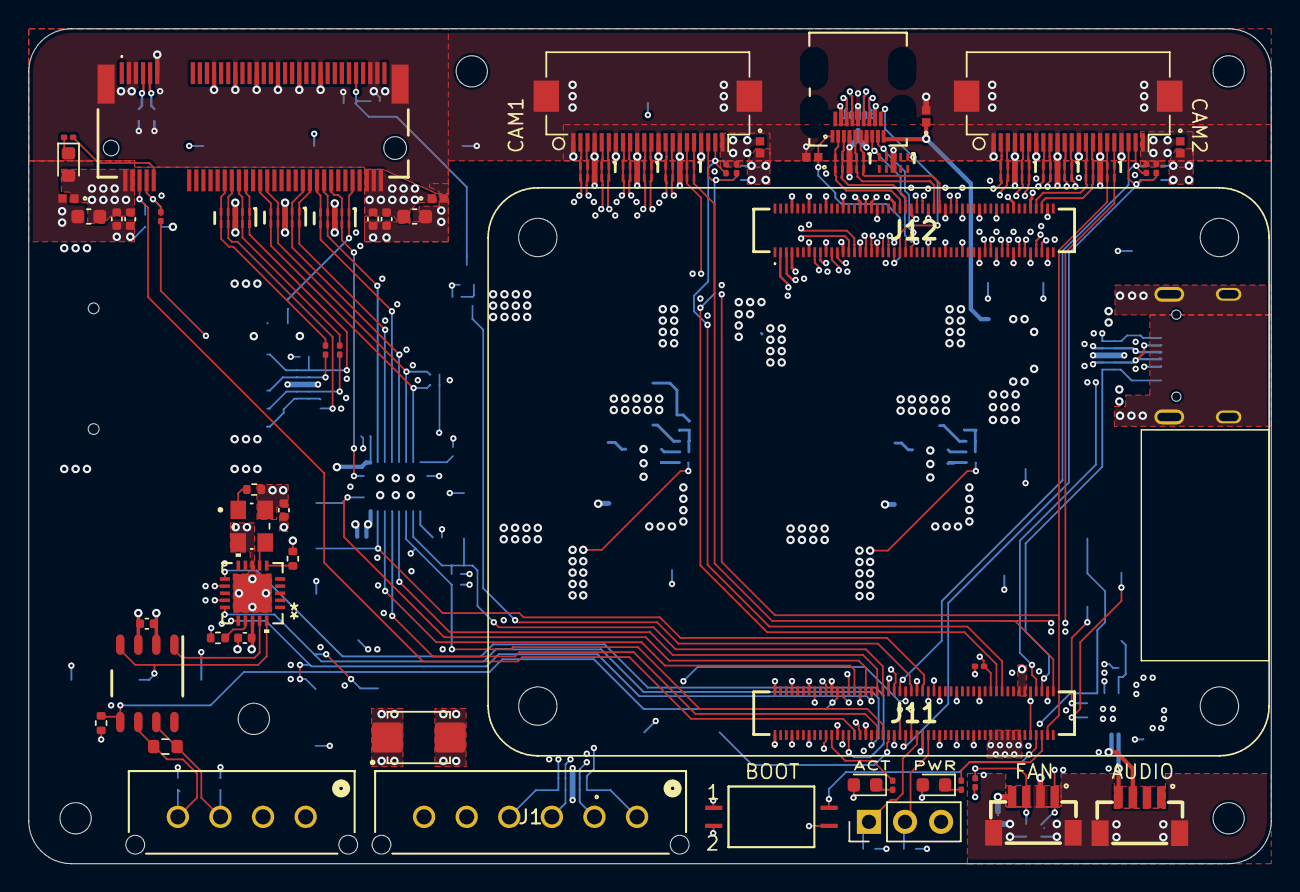
[picture p10: board hammerhead_sensor_module.kicad_pcb from above]

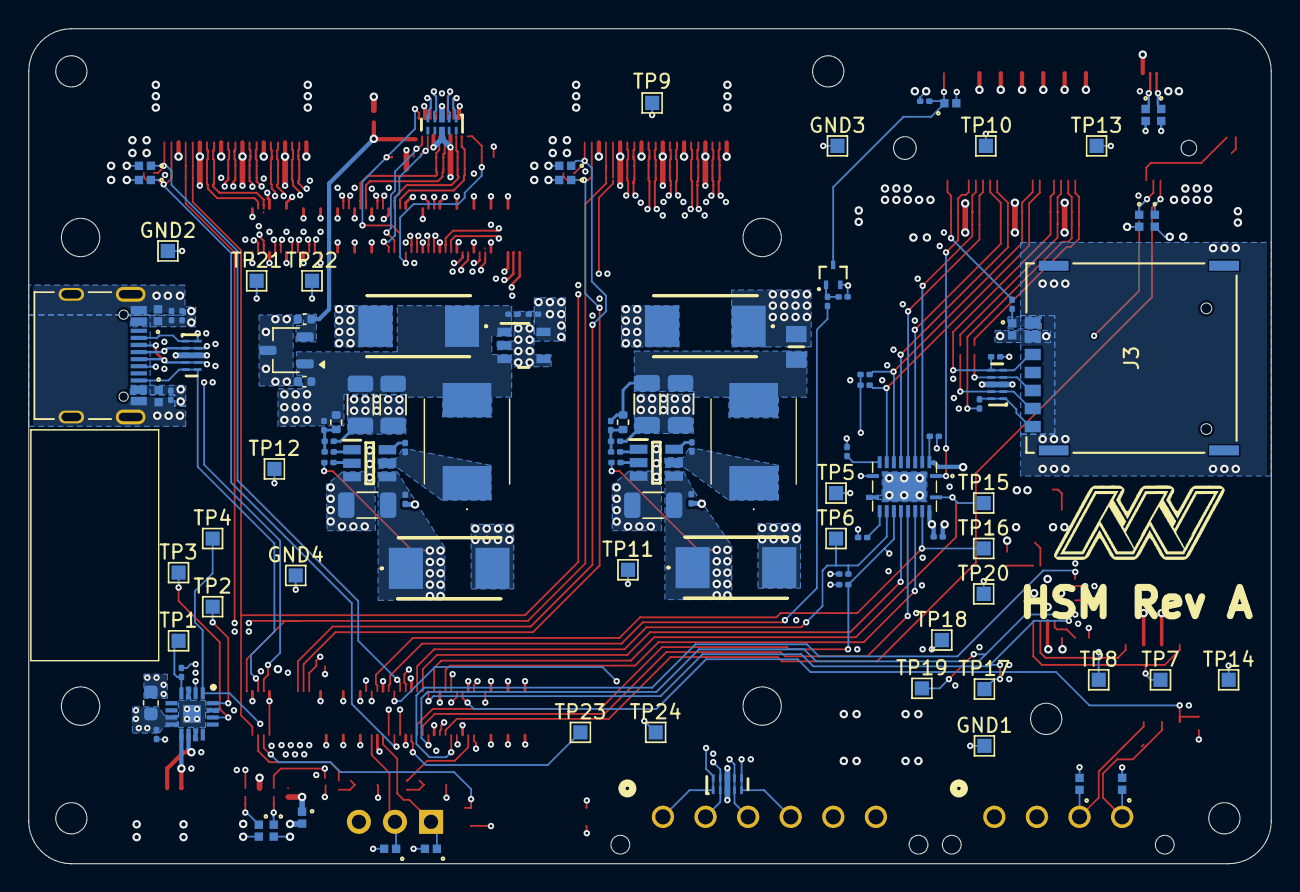
[picture p11: board hammerhead_sensor_module.kicad_pcb from below]

Board: 6 copper layers, 87.5 x 58.8 mm, 174 parts (111 on the bottom side), 130 nets.

Other parts of the board:
Module1: ComputeModule5-CM5; Raspberry-Pi-5-Compute-Module
