alexcwu1121/hammerhead-sensor-module/(commit log)

2026-03-21 upload kicad design files
    [cellular_modem.kicad_sch, cm5_gpio.kicad_sch, cm5_highspeed.kicad_sch, hammerhead_sensor_module.kicad_pcb, hammerhead_sensor_module.kicad_sch, power.kicad_sch, sensor_cluster.kicad_sch, sim7600g_h_m2b.kicad_sch]
2026-07-22 finish first pcb revision
    [cm5_gpio.kicad_sch, cm5_highspeed.kicad_sch, hammerhead_sensor_module.kicad_pcb, hammerhead_sensor_module.kicad_sch, hdmi.kicad_sch, mipi_csi2_camera_port.kicad_sch, power.kicad_sch, sensor_cluster.kicad_sch]
2026-07-22 update changelog v0.0.0->v0.0.1
    [hammerhead_sensor_module.kicad_pcb]
2026-07-22 add schematic docs and image of robot
    [hammerhead_sensor_module.kicad_pcb, hammerhead_sensor_module.kicad_sch]
2026-07-23 add docs and cleanup
    [cm5_gpio.kicad_sch, cm5_highspeed.kicad_sch, hammerhead_sensor_module.kicad_pcb, hammerhead_sensor_module.kicad_sch, hdmi.kicad_sch, power.kicad_sch, sim7600g_h_m2b.kicad_sch]
2026-07-24 assign 3d models
    [hammerhead_sensor_module.kicad_pcb]
2026-07-24 add power testpoints, add debug gpio testpoints, add comms testpoints, add logo, add component orientation silkscreen, add board name and revision silkscreen
    [cm5_gpio.kicad_sch, hammerhead_sensor_module.kicad_pcb, hammerhead_sensor_module.kicad_sch]
2026-07-24 increase minimum clearance tolerance by 0.01mm
2026-07-26 remove incorrect LED orientation markers
2026-08-22 add can controller and transceiver, replace jst connectors with molex micro fit connectors
2026-08-26 add can controller and transceiver, replace platform power connector with one with more appropriate current rating, add return vias
